hacklabkyiv/openox-pcb/README.md

# openox-pcb
PCB design for OpenOx - open source oxygen concentrator
