hacklabkyiv/openox-pcb/openOx.pdf

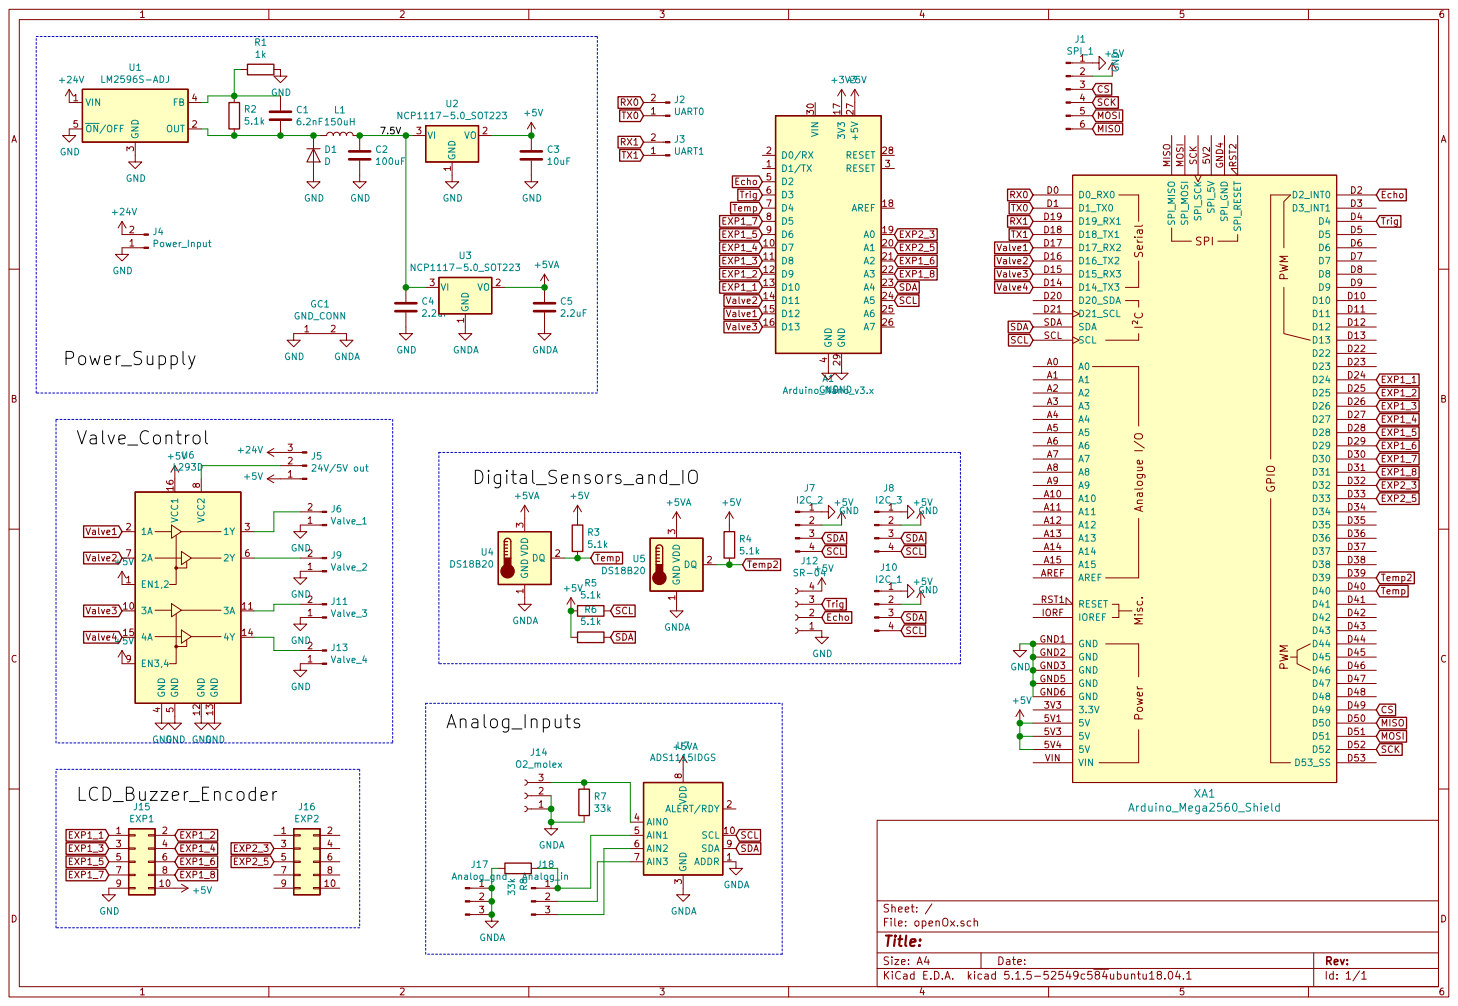
[picture p1: page 1]

1 VO 2 VI 3 U2 NCP1117-5.0_SOT223 GND GNDA

+5VGND GND GND GND GND

File: openOx.sch Sheet: /
Id: 1/1 Title:
