hacklabkyiv/openox-pcb/openOx.kicad_pcb

## KiCad design openOx.kicad_pcb (2020-04-06)

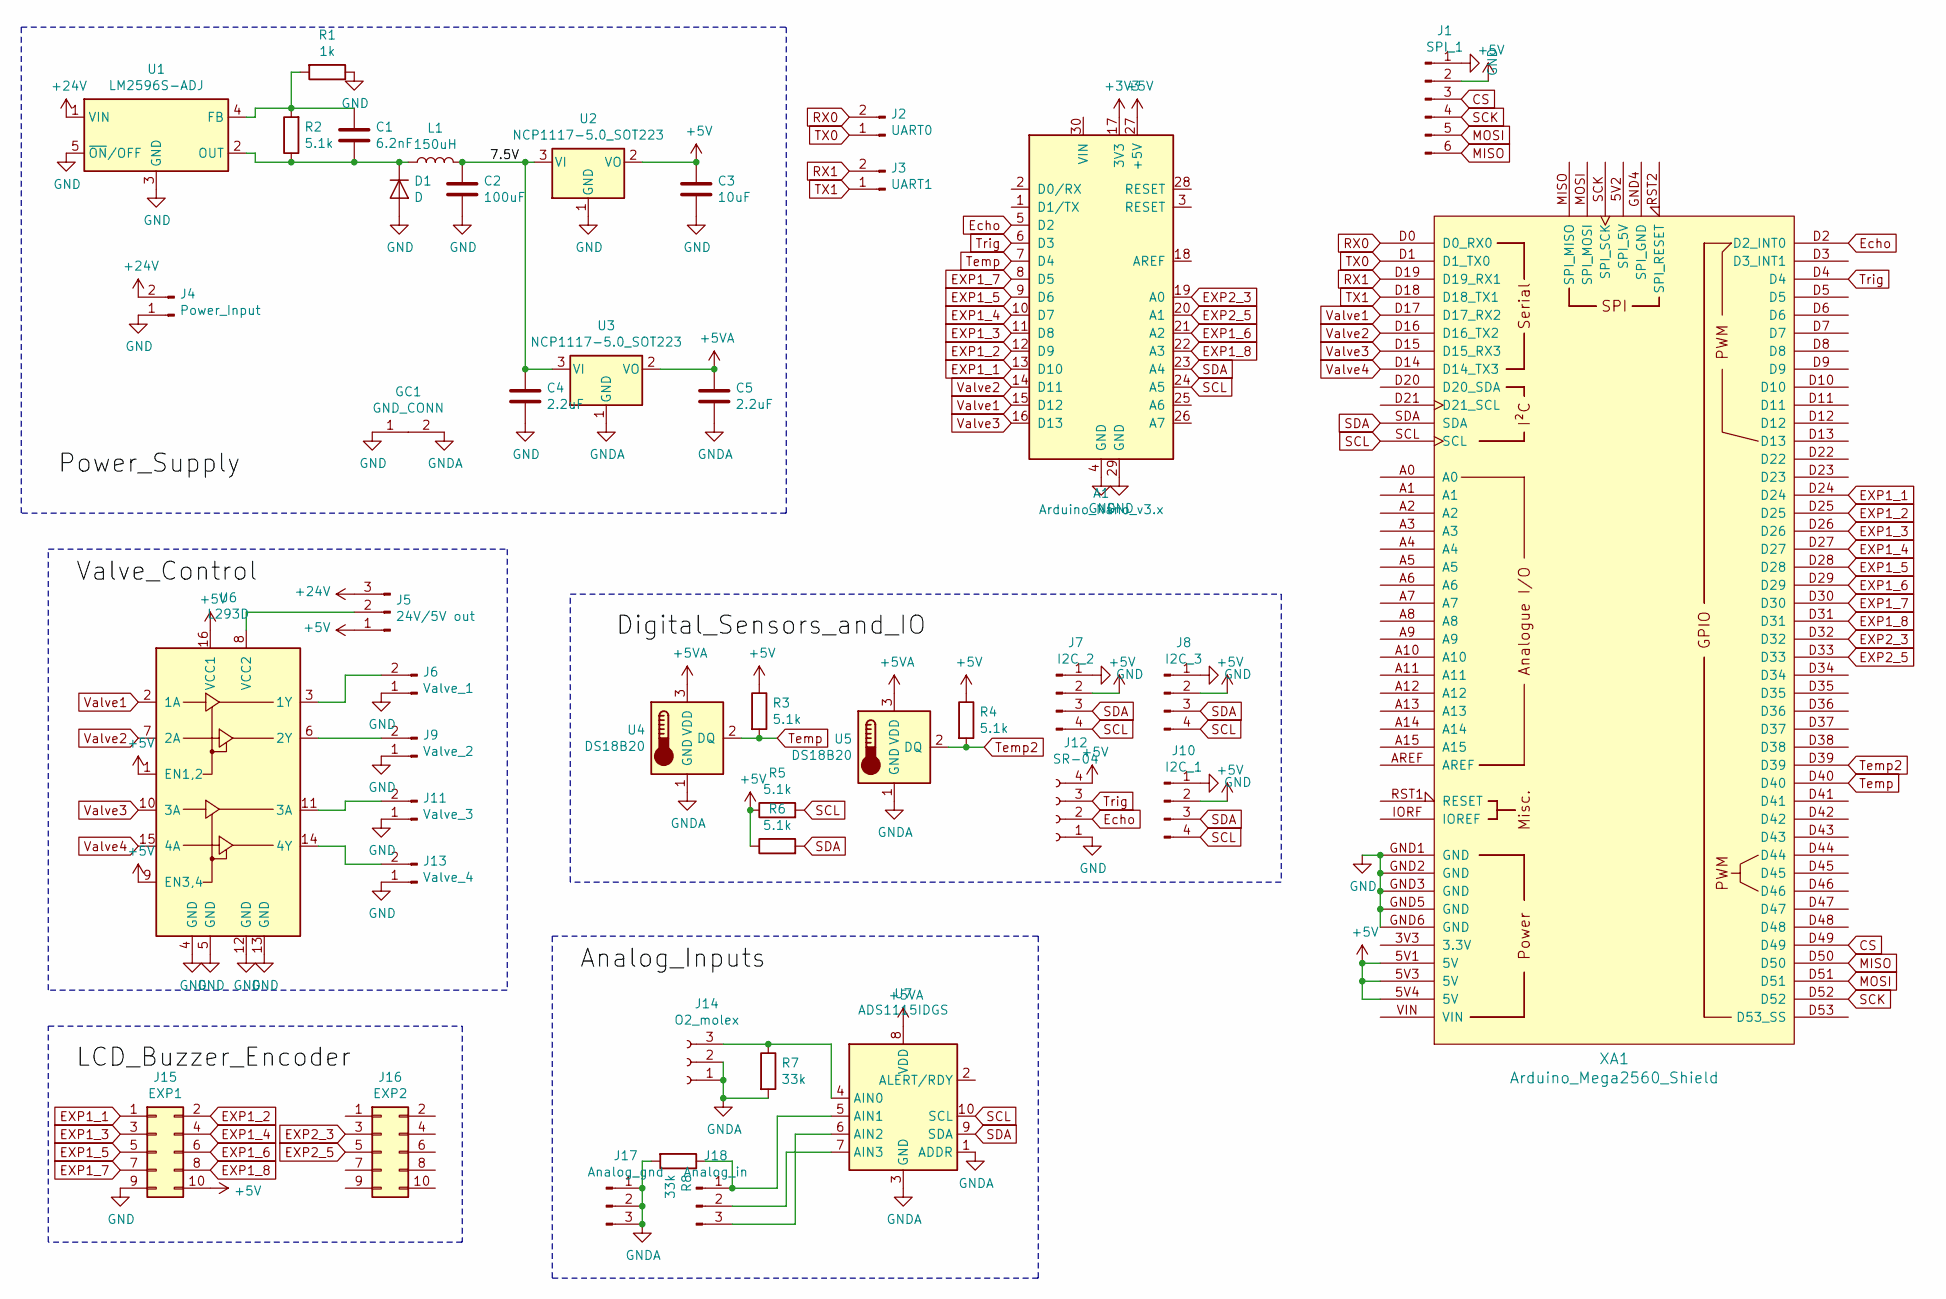
[picture p2: schematic openOx.sch]

Parts:
A1: Arduino_Nano_v3.x; Arduino_Nano
C1: 6.2nF; C_0805_2012Metric
C2: 100uF; C_1206_3216Metric
C3: 10uF; C_0805_2012Metric
C4, C5: 2.2uF; C_0805_2012Metric
D1: D; D_SOD-123
GC1: GND_CONN
J1: SPI_1; PinHeader_1x06_P2.54mm_Vertical
J2: UART0; PinHeader_1x02_P2.54mm_Vertical
J3: UART1; PinHeader_1x02_P2.54mm_Vertical
J4: Power_Input; TerminalBlock_TE_282834-2_1x02_P2.54mm_Horizontal
J5: 24V/5V out; PinHeader_1x03_P2.54mm_Vertical
J6: Valve_1; TerminalBlock_TE_282834-2_1x02_P2.54mm_Horizontal
J7: I2C_2; PinHeader_1x04_P2.54mm_Vertical
J8: I2C_3; PinHeader_1x04_P2.54mm_Vertical
J9: Valve_2; TerminalBlock_TE_282834-2_1x02_P2.54mm_Horizontal
J10: I2C_1; PinHeader_1x04_P2.54mm_Vertical
J11: Valve_3; TerminalBlock_TE_282834-2_1x02_P2.54mm_Horizontal
J12: SR-04; PinHeader_1x04_P2.54mm_Vertical
J13: Valve_4; TerminalBlock_TE_282834-2_1x02_P2.54mm_Horizontal
J14: O2_molex; Molex_KK-254_AE-6410-03A_1x03_P2.54mm_Vertical
J15: EXP1; IDC-Header_2x05_P2.54mm_Vertical
J16: EXP2; IDC-Header_2x05_P2.54mm_Vertical
J17: Analog_gnd; PinHeader_1x03_P2.54mm_Vertical
J18: Analog_in; PinHeader_1x03_P2.54mm_Vertical
L1: 150uH; L_Bourns_SRR1260
R1: 1k; R_0805_2012Metric
R2, R3, R4, R5, R6: 5.1k; R_0805_2012Metric
R7, R8: 33k; R_0805_2012Metric
U1: LM2596S-ADJ; TO-263-5_TabPin3
U2, U3: NCP1117-5.0_SOT223; SOT-223-3_TabPin2
U4, U5: DS18B20; PinHeader_1x03_P2.54mm_Vertical
U6: L293D; DIP-16_W7.62mm
U7: ADS1115IDGS; TSSOP-10_3x3mm_P0.5mm
XA1: Arduino_Mega2560_Shield

Connections:
+3V3: A1.17 (3V3)
+5V: A1.27 (+5V), C3.1, J1.2, J5.1, J7.2, J8.2, J10.2, J12.4, J15.10, R3.1, R4.1, R5.1, R6.1, U2.2 (VO), U6.1 (EN1,2), U6.9 (EN3,4), U6.16 (VCC1), XA1.5V1 (5V), XA1.5V3 (5V), XA1.5V4 (5V)
+5VA: C5.1, U3.2 (VO), U4.3 (VDD), U5.3 (VDD), U7.8 (VDD)
+24V: J4.2, J5.3, U1.1 (VIN)
/7.5V: C2.1, C4.1, L1.2, U2.3 (VI), U3.3 (VI)
CS: J1.3, XA1.D49
EXP1_1: A1.13 (D10), J15.1, XA1.D24
EXP1_2: A1.12 (D9), J15.2, XA1.D25
EXP1_3: A1.11 (D8), J15.3, XA1.D26
EXP1_4: A1.10 (D7), J15.4, XA1.D27
EXP1_5: A1.9 (D6), J15.5, XA1.D28
EXP1_6: A1.21 (A2), J15.6, XA1.D29
EXP1_7: A1.8 (D5), J15.7, XA1.D30
EXP1_8: A1.22 (A3), J15.8, XA1.D31
EXP2_3: A1.19 (A0), J16.3, XA1.D32
EXP2_5: A1.20 (A1), J16.5, XA1.D33
Echo: A1.5 (D2), J12.2, XA1.D2 (D2_INT0)
GND: A1.4 (GND), A1.29 (GND), C2.2, C3.2, C4.2, D1.2 (A), GC1.1, J1.1, J4.1, J6.1, J7.1, J8.1, J9.1, J10.1, J11.1, J12.1, J13.1, J15.9, R1.1, U1.3 (GND), U1.5 (~ON~/OFF), U2.1 (GND), U6.4 (GND), U6.5 (GND), U6.12 (GND), U6.13 (GND), XA1.GND1 (GND), XA1.GND2 (GND), XA1.GND3 (GND), XA1.GND5 (GND), XA1.GND6 (GND)
GNDA: C5.2, GC1.2, J14.1, J14.2, J17.1, J17.2, J17.3, R7.2, R8.2, U3.1 (GND), U4.1 (GND), U5.1 (GND), U7.1 (ADDR), U7.3 (GND)
MISO: J1.6, XA1.D50
MOSI: J1.5, XA1.D51
unnamed: C1.1, R1.2, R2.2, U1.4 (FB)
unnamed: C1.2, D1.1 (K), L1.1, R2.1, U1.2 (OUT)
unnamed: J5.2, U6.8 (VCC2)
unnamed: J6.2, U6.3 (1Y)
unnamed: J9.2, U6.6 (2Y)
unnamed: J11.2, U6.11 (3A)
unnamed: J13.2, U6.14 (4Y)
unnamed: J14.3, R7.1, U7.4 (AIN0)
unnamed: J18.1, R8.1, U7.5 (AIN1)
unnamed: J18.2, U7.7 (AIN3)
unnamed: J18.3, U7.6 (AIN2)
RX0: J2.2, XA1.D0 (D0_RX0)
RX1: J3.2, XA1.D19 (D19_RX1)
SCK: J1.4, XA1.D52
SCL: A1.24 (A5), J7.4, J8.4, J10.4, R5.2, U7.10 (SCL), XA1.SCL
SDA: A1.23 (A4), J7.3, J8.3, J10.3, R6.2, U7.9 (SDA), XA1.SDA
TX0: J2.1, XA1.D1 (D1_TX0)
TX1: J3.1, XA1.D18 (D18_TX1)
Temp: A1.7 (D4), R3.2, U4.2 (DQ), XA1.D40
Temp2: R4.2, U5.2 (DQ), XA1.D39
Trig: A1.6 (D3), J12.3, XA1.D4
Valve1: A1.15 (D12), U6.2 (1A), XA1.D17 (D17_RX2)
Valve2: A1.14 (D11), U6.7 (2A), XA1.D16 (D16_TX2)
Valve3: A1.16 (D13), U6.10 (3A), XA1.D15 (D15_RX3)
Valve4: U6.15 (4A), XA1.D14 (D14_TX3)

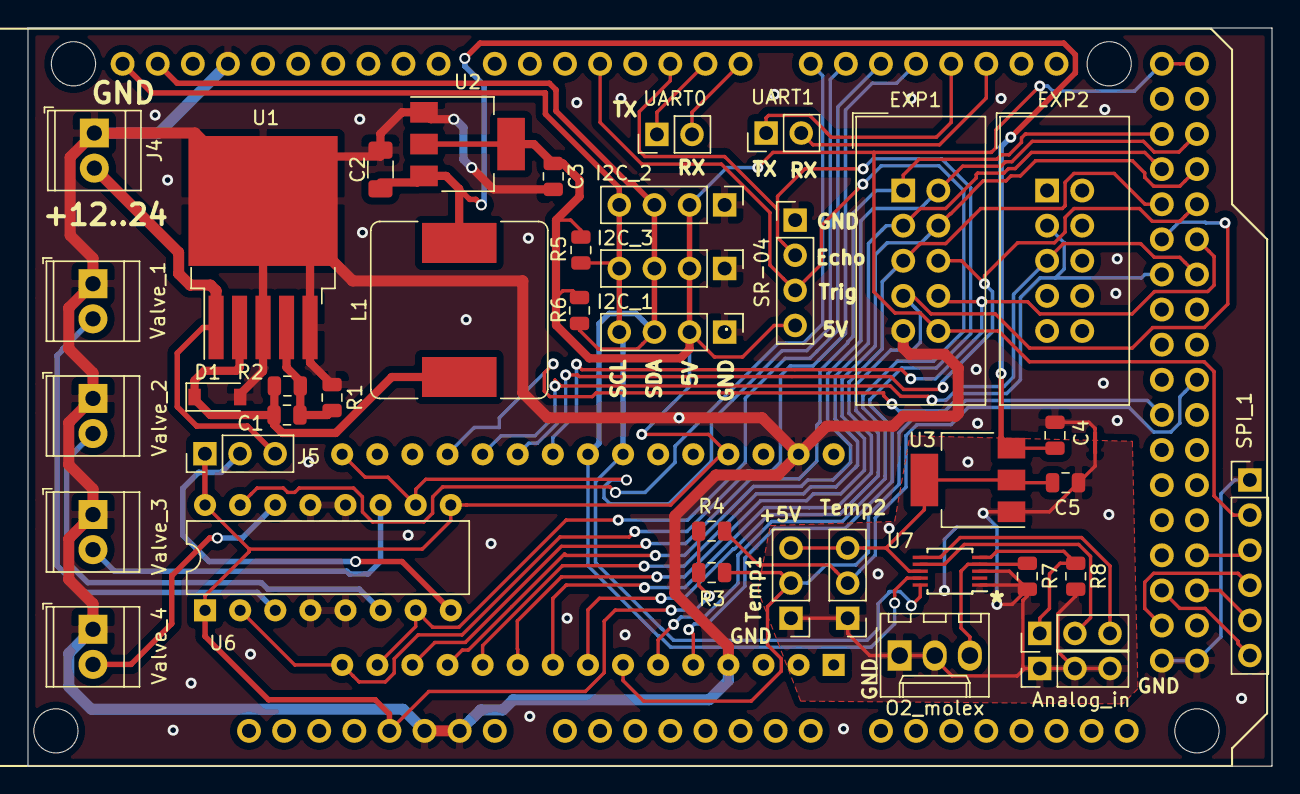
[picture p3: board openOx.kicad_pcb from above]

Board: 2 copper layers, 90.0 x 53.4 mm, 43 parts (1 on the bottom side), 45 nets.
