hacklabkyiv/openox-pcb/(commit log)

2020-04-03 first PCB revision in KiCAD and corresponding gerbers in .zip
    [openOx.kicad_pcb, openOx.sch]
2020-04-03 Deleted old schematics, was uploaded by mistake
2020-04-06 outline changed, C2 package changed
    [openOx.kicad_pcb, openOx.sch]
